Matheussoranco/Jensen-prosthetics/media/renders/mg996r_reference.jpg

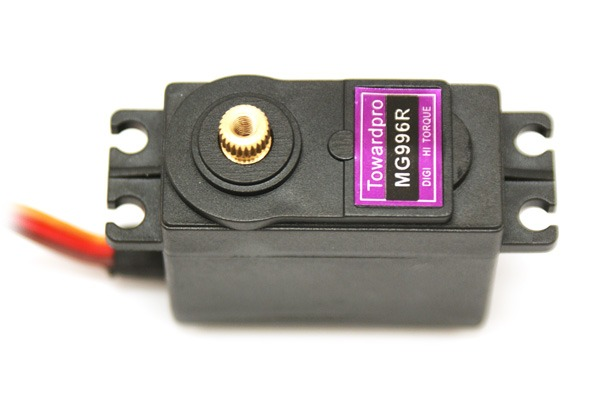
media/renders/mg996r_reference.jpg
