Matheussoranco/Jensen-prosthetics/media/renders/render_02.png

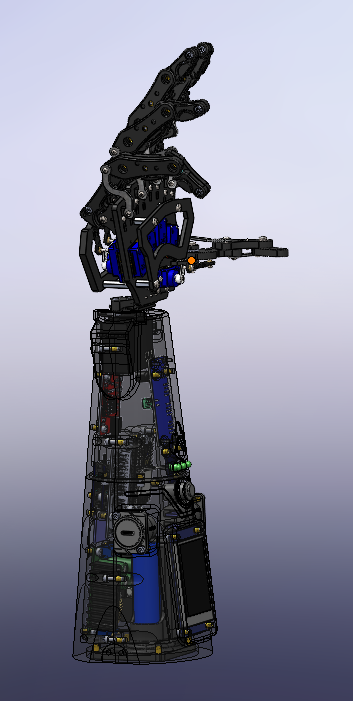
media/renders/render_02.png
