Matheussoranco/Jensen-prosthetics/media/renders/mg996r_reference.png

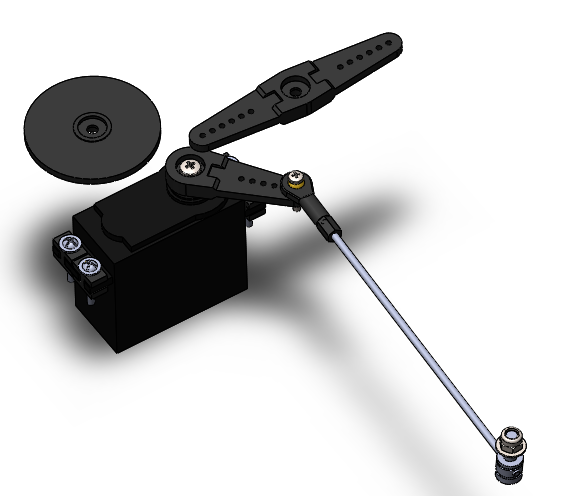
media/renders/mg996r_reference.png
