Matheussoranco/Jensen-prosthetics/media/renders/render_01.png

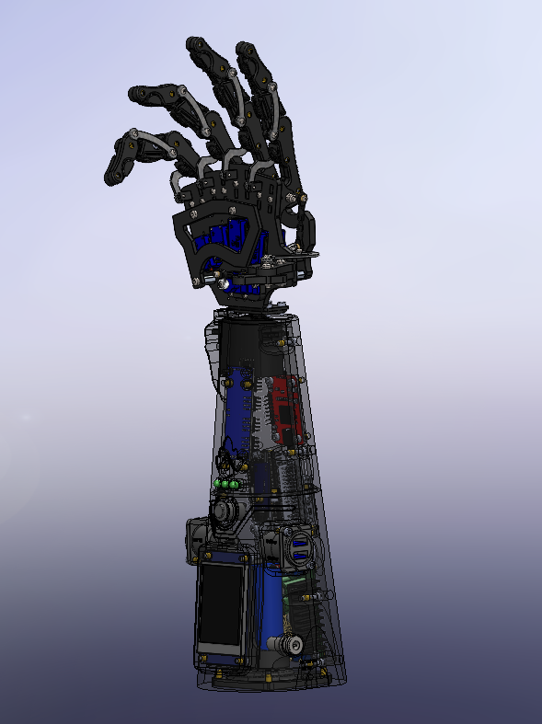
media/renders/render_01.png
