Matheussoranco/Jensen-prosthetics/media/renders/render_03.png

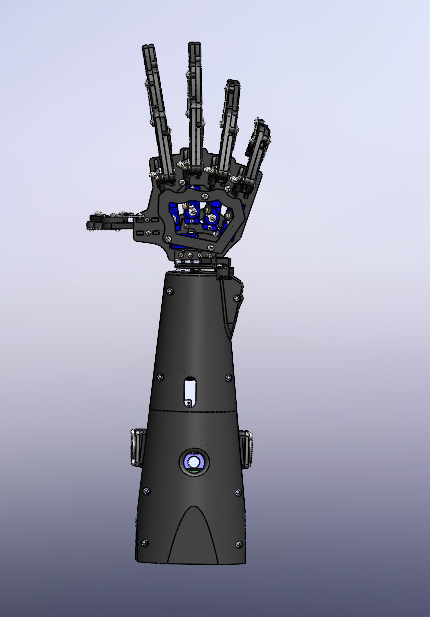
media/renders/render_03.png
