Matheussoranco/Jensen-prosthetics/media/renders/render_04.png

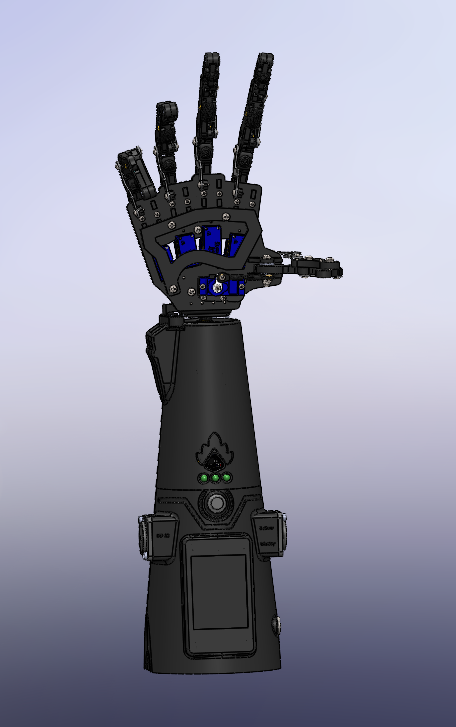
media/renders/render_04.png
