Matheussoranco/Jensen-prosthetics/media/renders/render_05.png

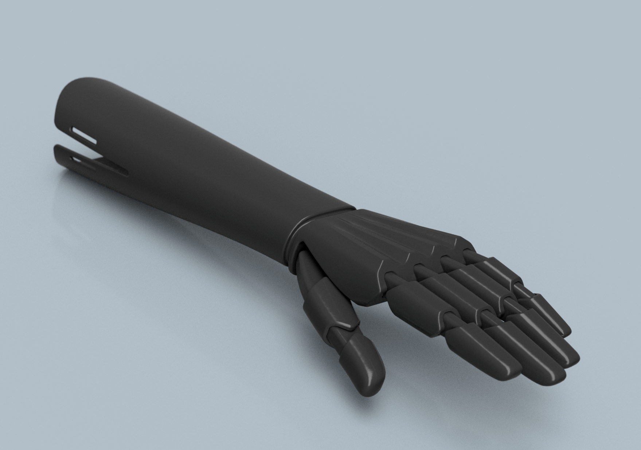
media/renders/render_05.png
