Matheussoranco/Jensen-prosthetics/media/renders/render_06.png

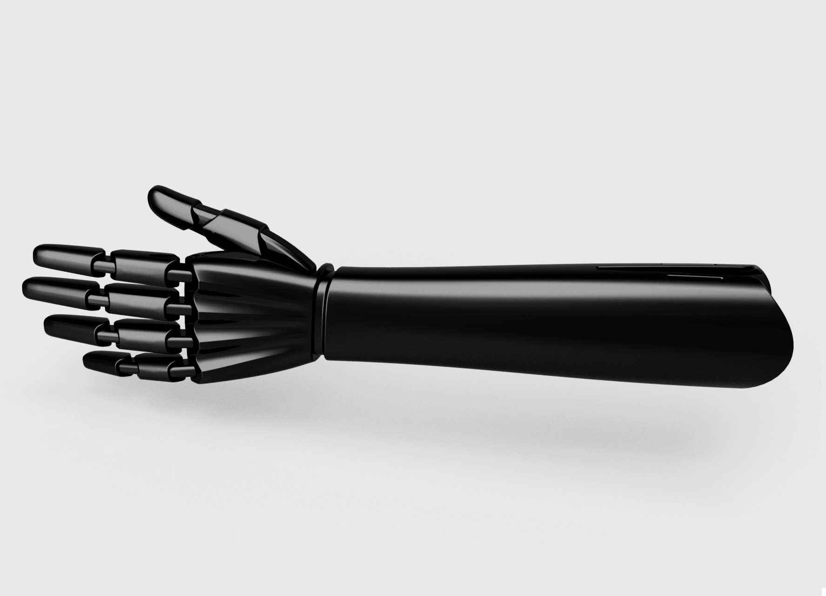
media/renders/render_06.png
