Matheussoranco/Jensen-prosthetics/hardware/components/MG996R_Servo/Att_2_100.STEP

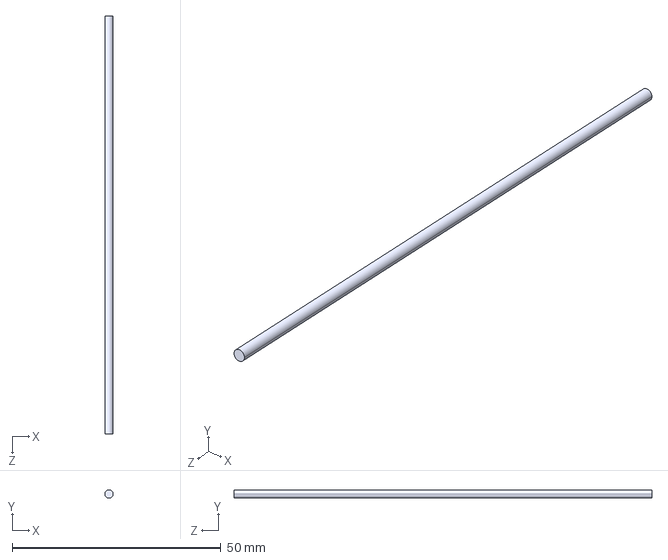
[picture p9: CAD file, 2026-08-06]
hardware/components/MG996R_Servo/Att_2_100.STEP
2.00 x 2.00 x 100.0 mm
