Matheussoranco/Jensen-prosthetics/hardware/components/PCA9685_PWM_Driver.stp

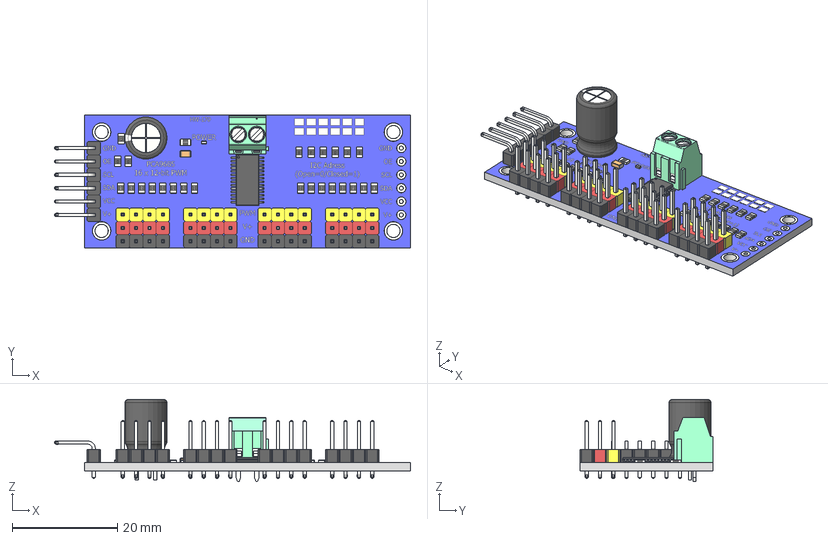
[picture p10: CAD file, 2026-08-06]
hardware/components/PCA9685_PWM_Driver.stp
67.7 x 25.3 x 15.6 mm
