Matheussoranco/Jensen-prosthetics/hardware/stl/Forearm_V1.2-Cut-Revolve1.STL

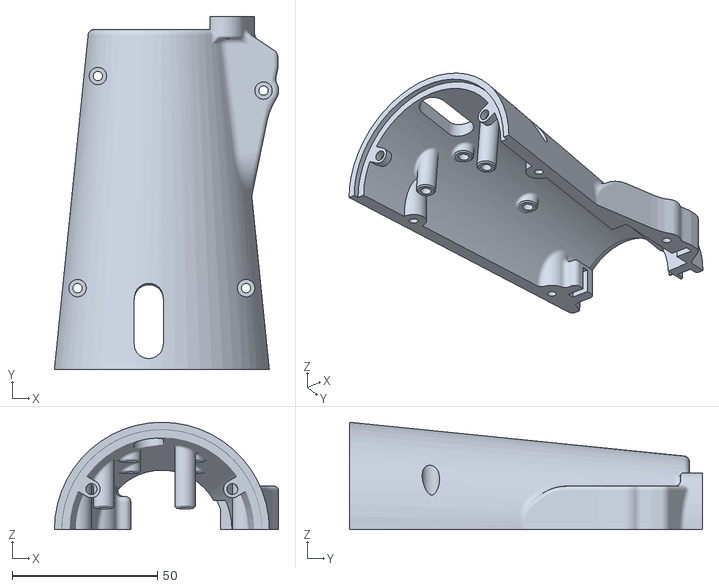
[picture p11: CAD file, 2026-08-06]
hardware/stl/Forearm_V1.2-Cut-Revolve1.STL
77.2 x 121.5 x 37.0
