Matheussoranco/Jensen-prosthetics/hardware/components/MG996R_Servo/Rubber.STEP

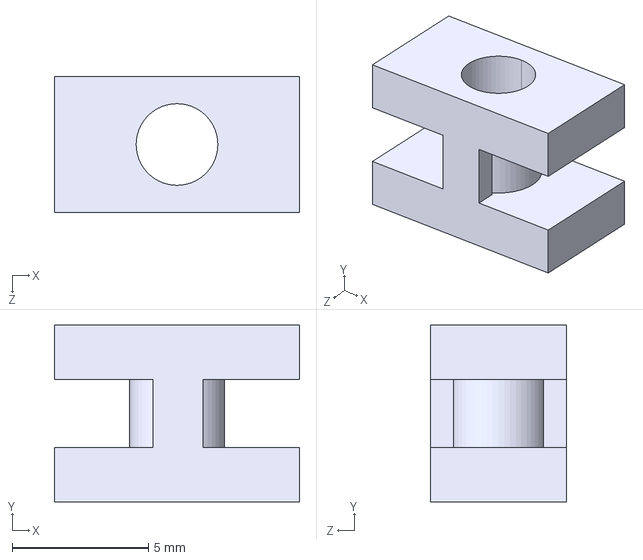
[picture p12: CAD file, 2026-08-06]
hardware/components/MG996R_Servo/Rubber.STEP
9.00 x 6.50 x 5.00 mm
