Matheussoranco/Jensen-prosthetics/hardware/components/Tie_Rod.step

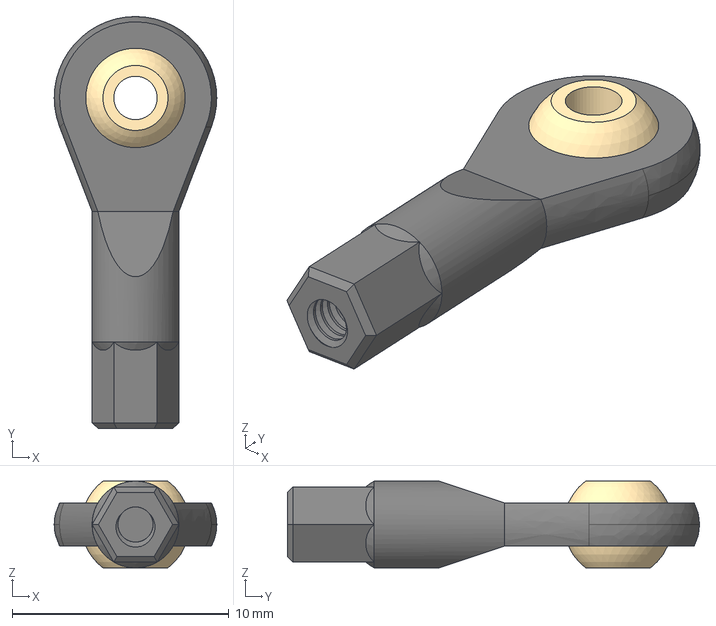
[picture p13: CAD file, 2026-08-06]
hardware/components/Tie_Rod.step
7.50 x 19.0 x 4.00 mm
