Matheussoranco/Jensen-prosthetics/hardware/components/MG996R_Servo/Arm_3.STEP

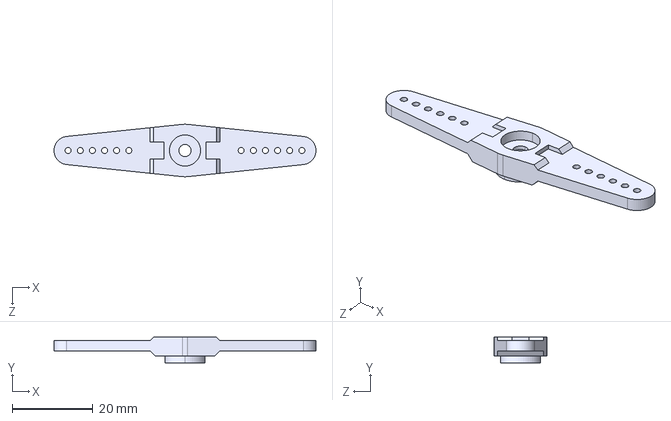
[picture p15: CAD file, 2026-08-06]
hardware/components/MG996R_Servo/Arm_3.STEP
64.8 x 6.40 x 13.0 mm
