Matheussoranco/Jensen-prosthetics/hardware/components/Nextion_2.4in_Display.step

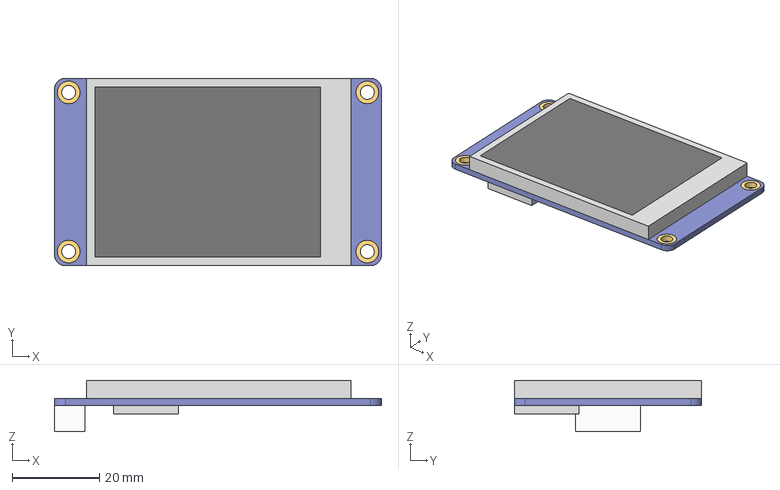
[picture p16: CAD file, 2026-08-06]
hardware/components/Nextion_2.4in_Display.step
75.0 x 43.0 x 11.7 mm
