Matheussoranco/Jensen-prosthetics/hardware/stl/Forearm_V1.2-Cut-Revolve2.STL

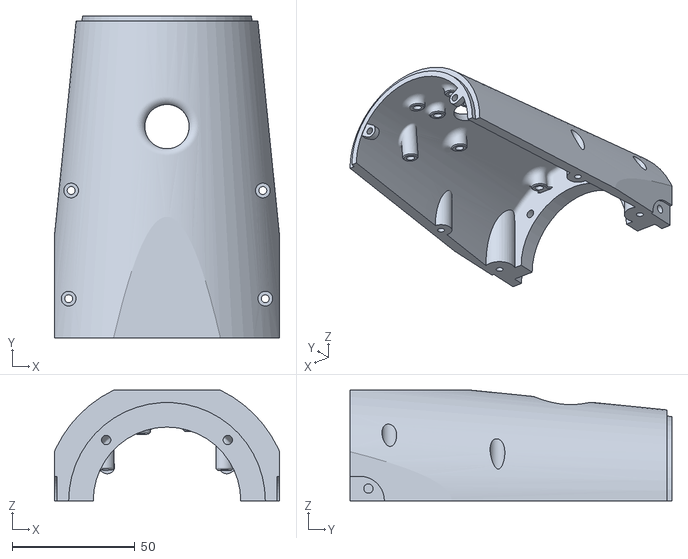
[picture p17: CAD file, 2026-08-06]
hardware/stl/Forearm_V1.2-Cut-Revolve2.STL
91.7 x 131.0 x 45.0
