Matheussoranco/Jensen-prosthetics/hardware/components/ESP32_DevBoard.stp

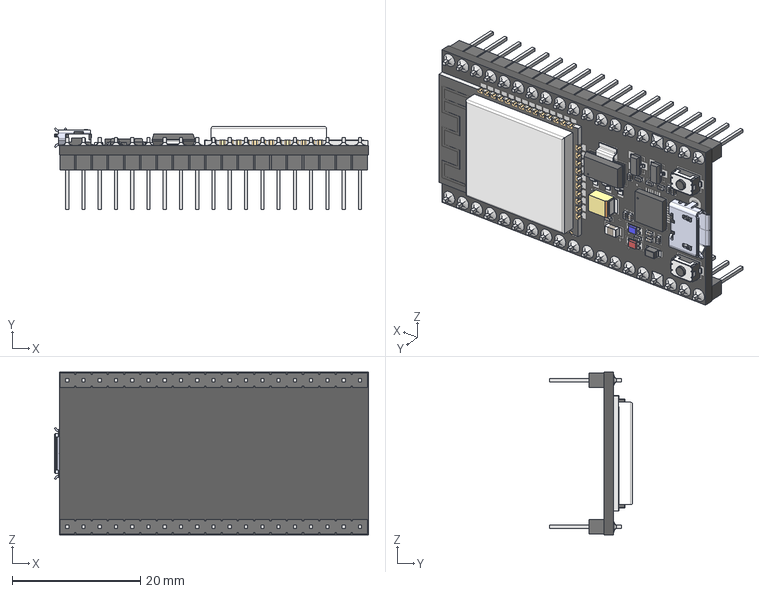
[picture p18: CAD file, 2026-08-06]
hardware/components/ESP32_DevBoard.stp
49.0 x 13.0 x 25.4 mm
