Matheussoranco/Jensen-prosthetics/hardware/components/MG996R_Servo/servo.STEP

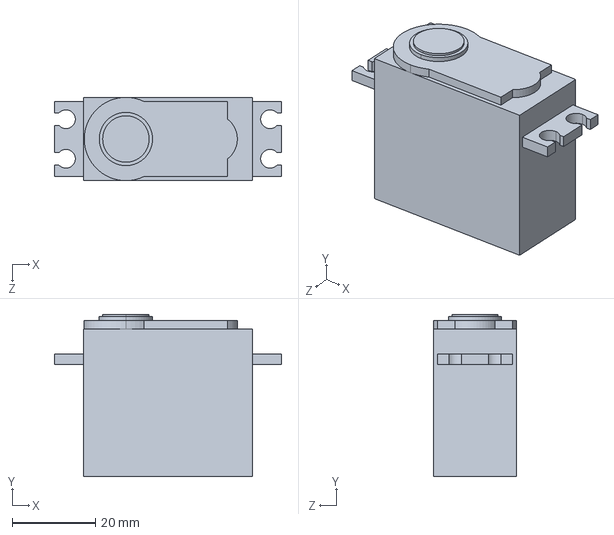
[picture p19: CAD file, 2026-08-06]
hardware/components/MG996R_Servo/servo.STEP
54.5 x 39.0 x 20.0 mm
