Matheussoranco/Jensen-prosthetics/hardware/stl/Base-Palm_Upor_V1.2.STL

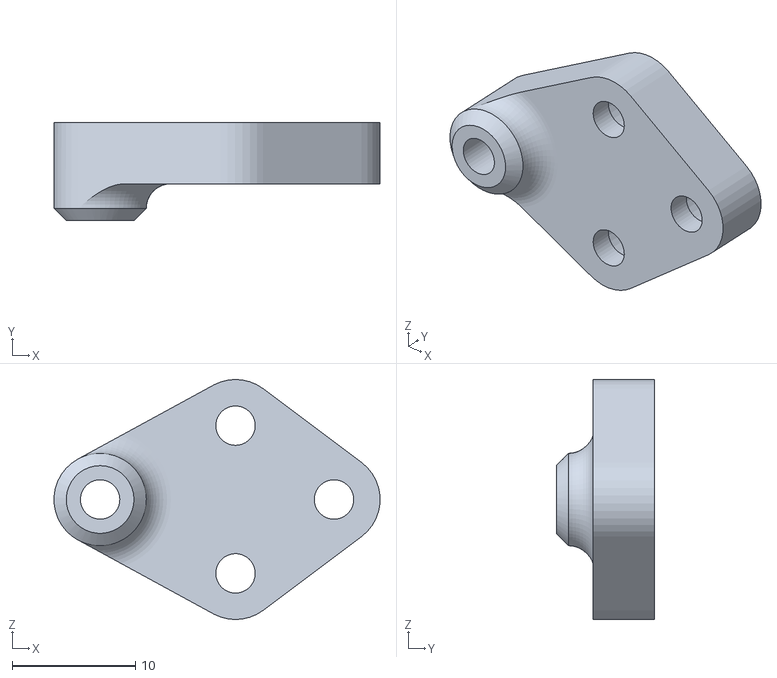
[picture p20: CAD file, 2026-08-06]
hardware/stl/Base-Palm_Upor_V1.2.STL
26.5 x 8.00 x 19.5
