Matheussoranco/Jensen-prosthetics/hardware/components/ESP32_Expansion_Board.step

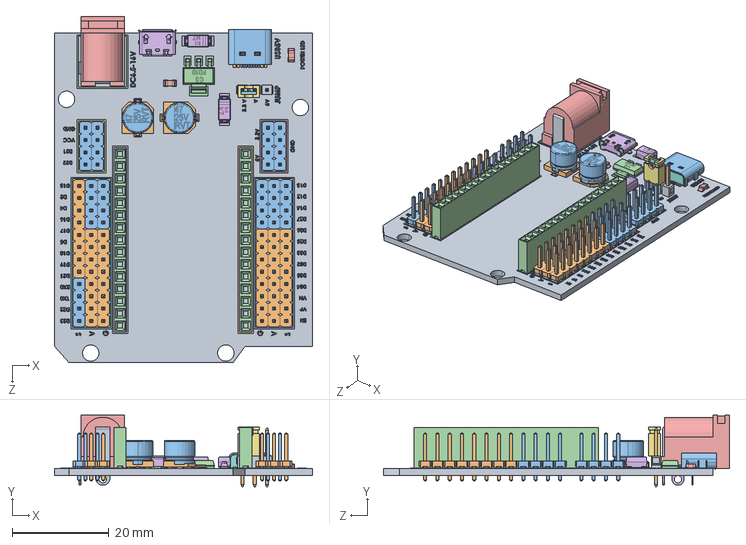
[picture p21: CAD file, 2026-08-06]
hardware/components/ESP32_Expansion_Board.step
53.4 x 14.8 x 71.7 mm
