Matheussoranco/Jensen-prosthetics/hardware/stl/Flanec_2.STL

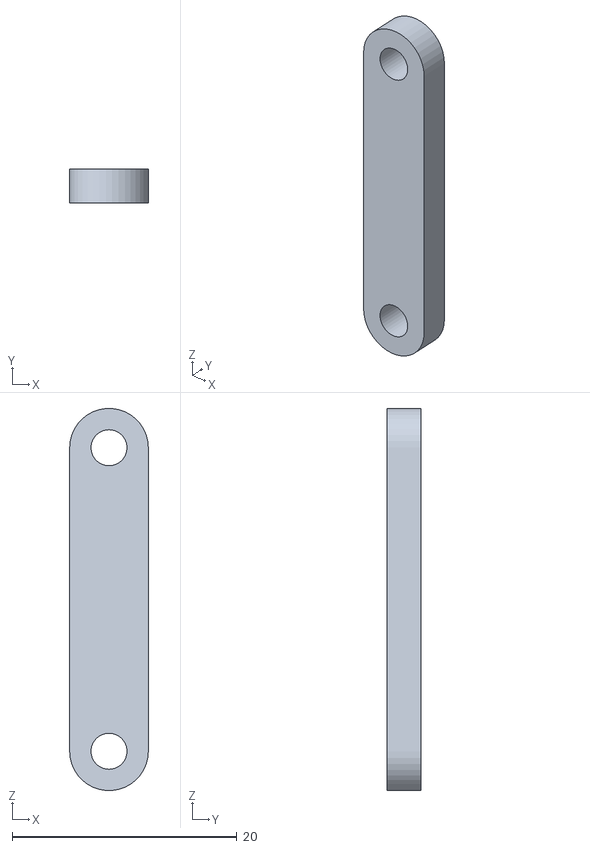
[picture p22: CAD file, 2026-08-06]
hardware/stl/Flanec_2.STL
7.00 x 3.00 x 34.0
