Matheussoranco/Jensen-prosthetics/hardware/components/LED_Green_5mm.stp

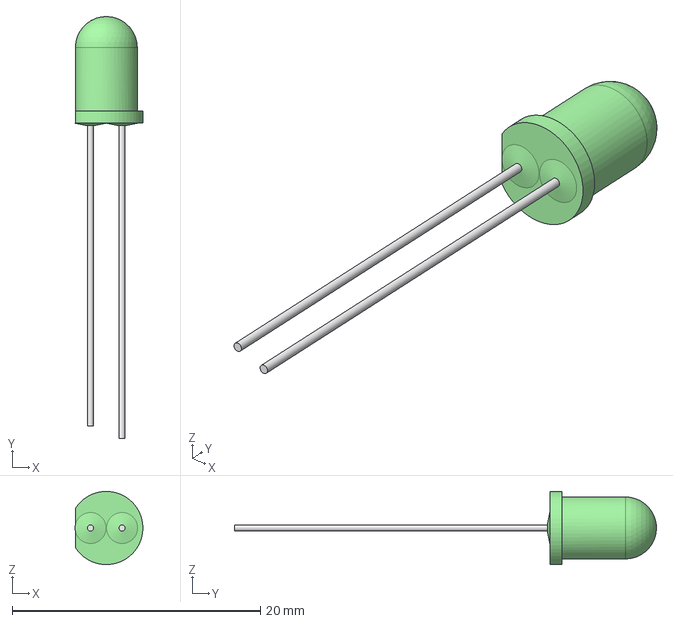
[picture p23: CAD file, 2026-08-06]
hardware/components/LED_Green_5mm.stp
5.47 x 34.0 x 5.90 mm
