Matheussoranco/Jensen-prosthetics/hardware/components/MG996R_Servo/Arm_1.STEP

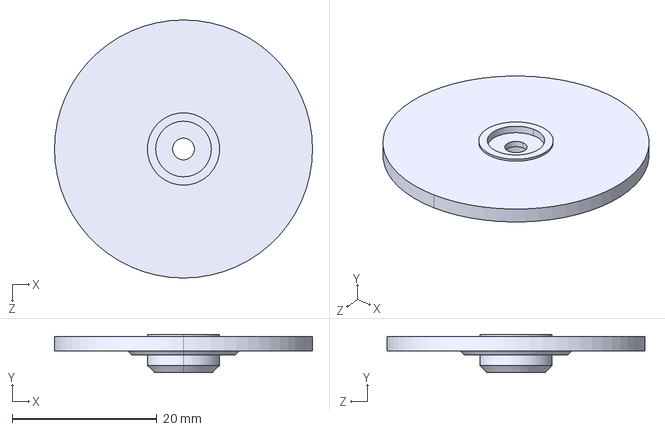
[picture p24: CAD file, 2026-08-06]
hardware/components/MG996R_Servo/Arm_1.STEP
35.7 x 5.30 x 35.7 mm
