Matheussoranco/Jensen-prosthetics/hardware/components/Buck_Converter_5-40V_9A.stp

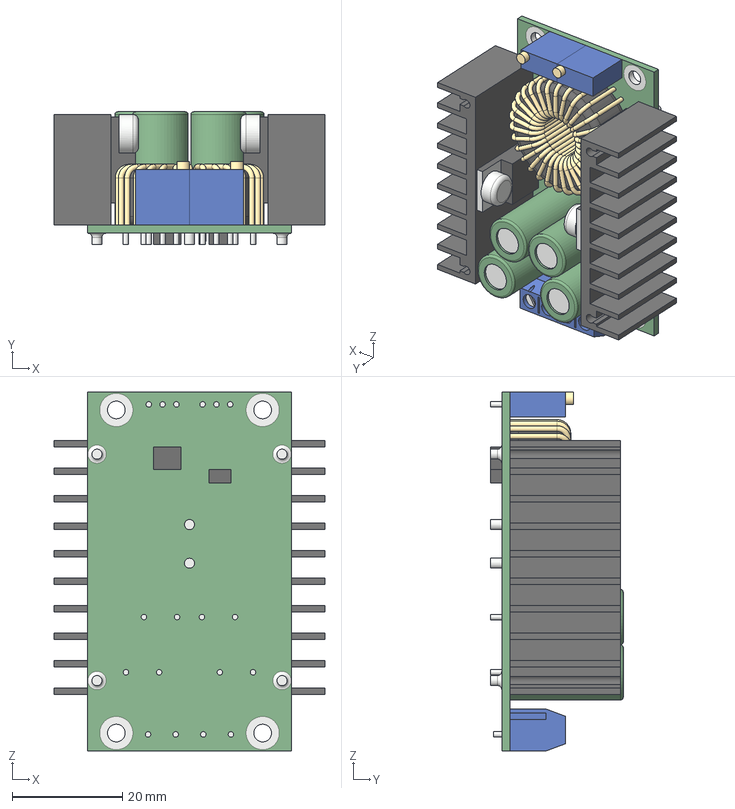
[picture p26: CAD file, 2026-08-06]
hardware/components/Buck_Converter_5-40V_9A.stp
49.0 x 24.0 x 65.0 mm
