Matheussoranco/Jensen-prosthetics/hardware/components/MG996R_Servo/shaft.STEP

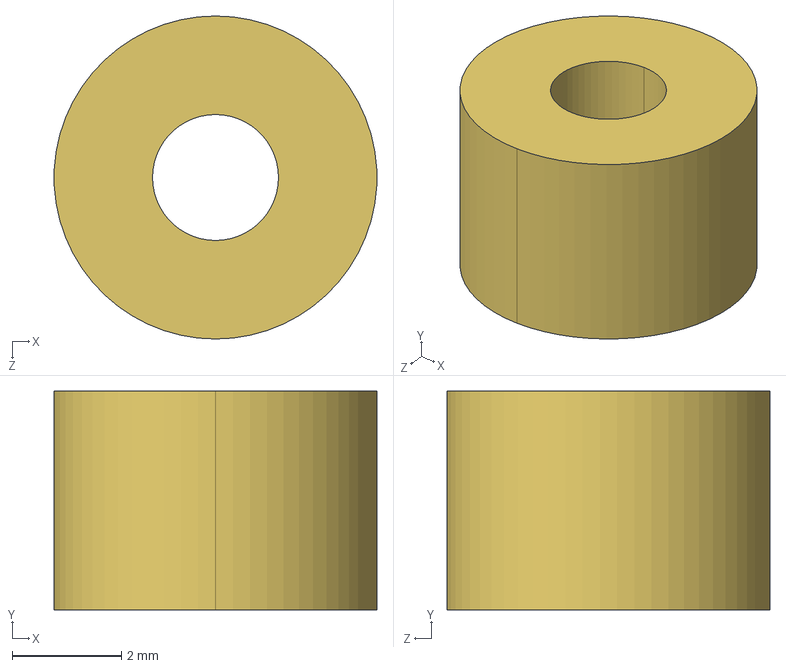
[picture p27: CAD file, 2026-08-06]
hardware/components/MG996R_Servo/shaft.STEP
5.89 x 4.00 x 5.90 mm
