Matheussoranco/Jensen-prosthetics/hardware/stl/Flanec.STL

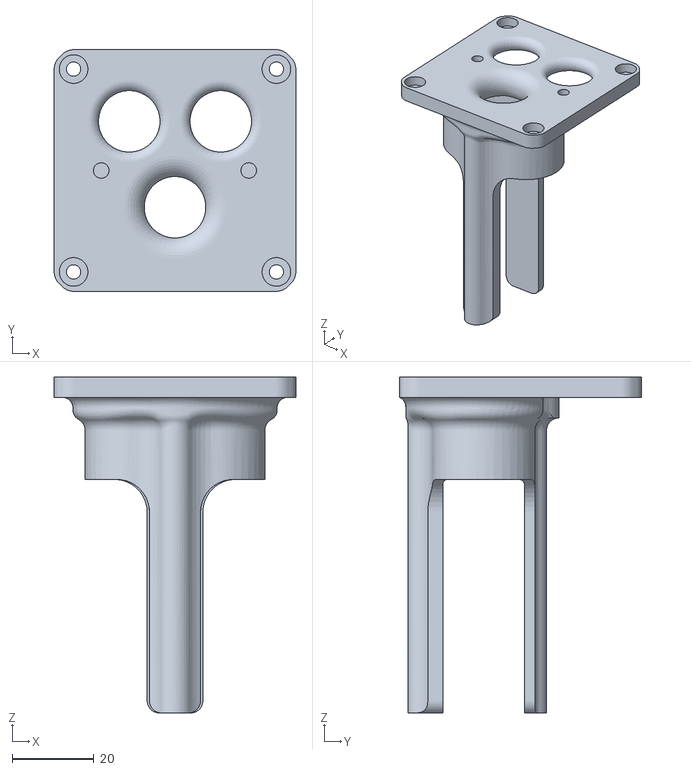
[picture p28: CAD file, 2026-08-06]
hardware/stl/Flanec.STL
59.0 x 59.0 x 82.0
