Matheussoranco/Jensen-prosthetics/hardware/components/MG996R_Servo/Att_3.STEP

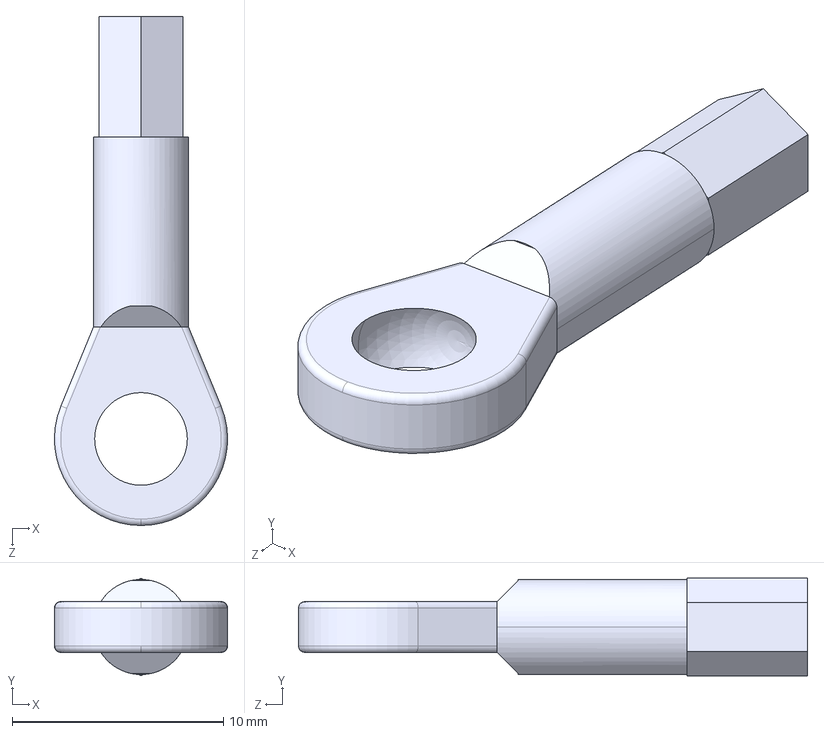
[picture p29: CAD file, 2026-08-06]
hardware/components/MG996R_Servo/Att_3.STEP
8.20 x 4.62 x 24.1 mm
