Matheussoranco/Jensen-prosthetics/hardware/components/MG996R_Servo/Arm_2.STEP

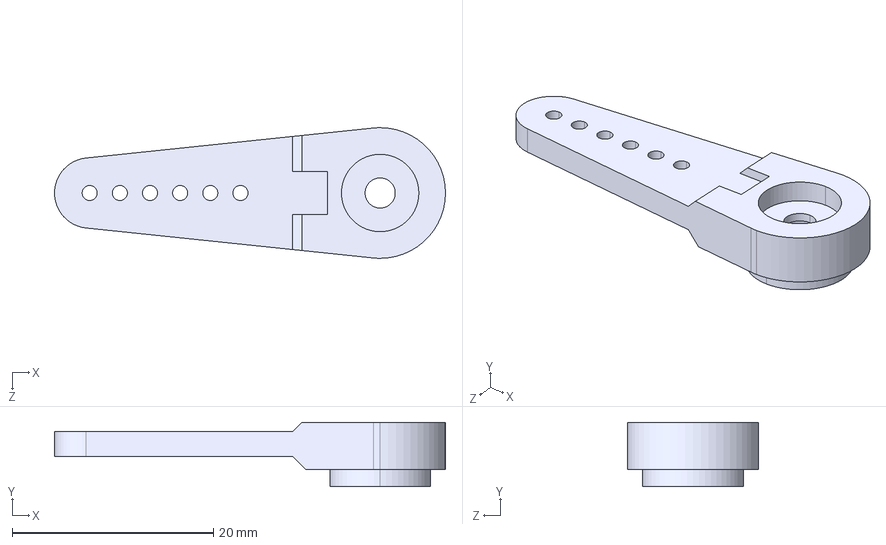
[picture p30: CAD file, 2026-08-06]
hardware/components/MG996R_Servo/Arm_2.STEP
38.9 x 6.40 x 13.0 mm
