Matheussoranco/Jensen-prosthetics/hardware/components/MG996R_Servo/MG996R.STEP

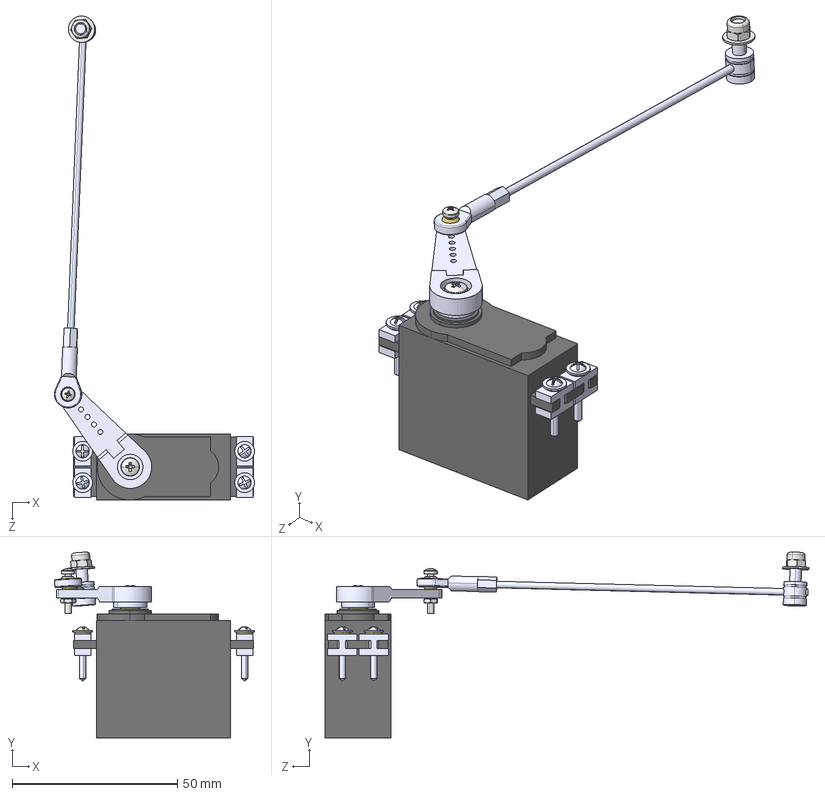
[picture p31: CAD file, 2026-08-06]
hardware/components/MG996R_Servo/MG996R.STEP
60.5 x 56.2 x 146.4 mm
servo
shaft
Rubber x 4
bushing x 4
screw x 4
Arm 2
pan head cross recess screw_din_DIN EN ISO 7045 - M3 x 6 - Z - 6N
Att 1
wave spring lock washer_din_DIN 137-B3-FSt
prevailing torque nut style 1 insert_din_DIN EN ISO 7040 - M3 - N
socket set screw flat point_din_DIN 913 - M4 x 4-N
Att 2 100
Att 3
Att 4
pan head cross recess screw_din_DIN EN ISO 7045 - M2 x 12 - Z - 12N
hex thin nut chamfered gradeab_din_Hexagon Thin Nut ISO 4035 - M2 - N
