Matheussoranco/Jensen-prosthetics/hardware/components/MG996R_Servo/Att_4.STEP

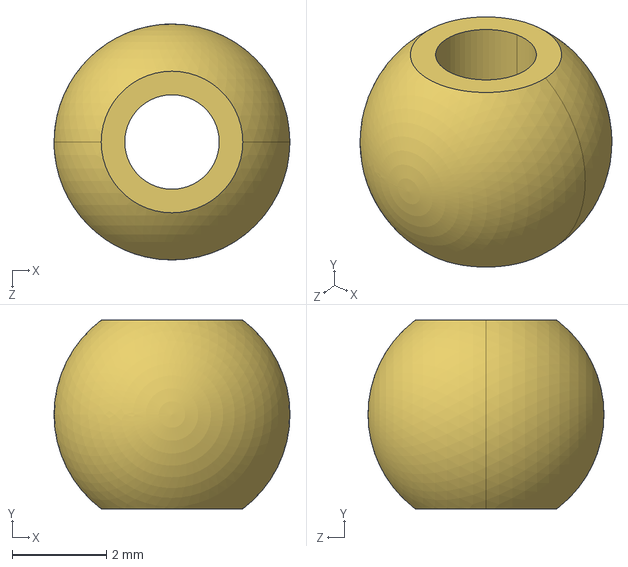
[picture p32: CAD file, 2026-08-06]
hardware/components/MG996R_Servo/Att_4.STEP
5.00 x 4.00 x 5.00 mm
