Matheussoranco/Jensen-prosthetics/hardware/components/MG996R_Servo/bushing.STEP

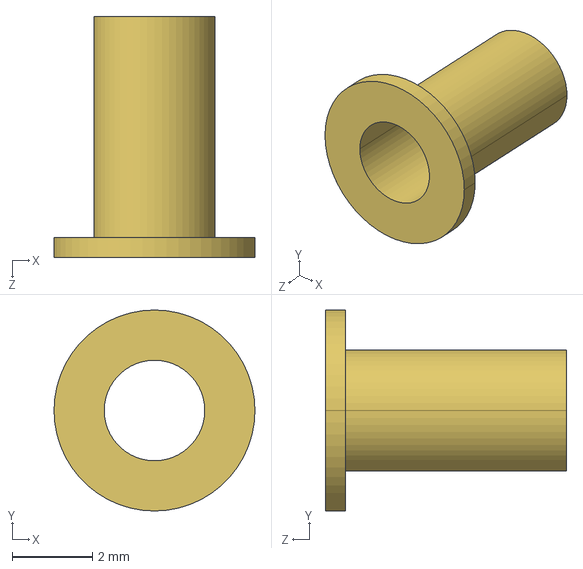
[picture p33: CAD file, 2026-08-06]
hardware/components/MG996R_Servo/bushing.STEP
5.00 x 5.00 x 6.00 mm
