Matheussoranco/Jensen-prosthetics/hardware/components/MG996R_Servo/ATT2.STEP

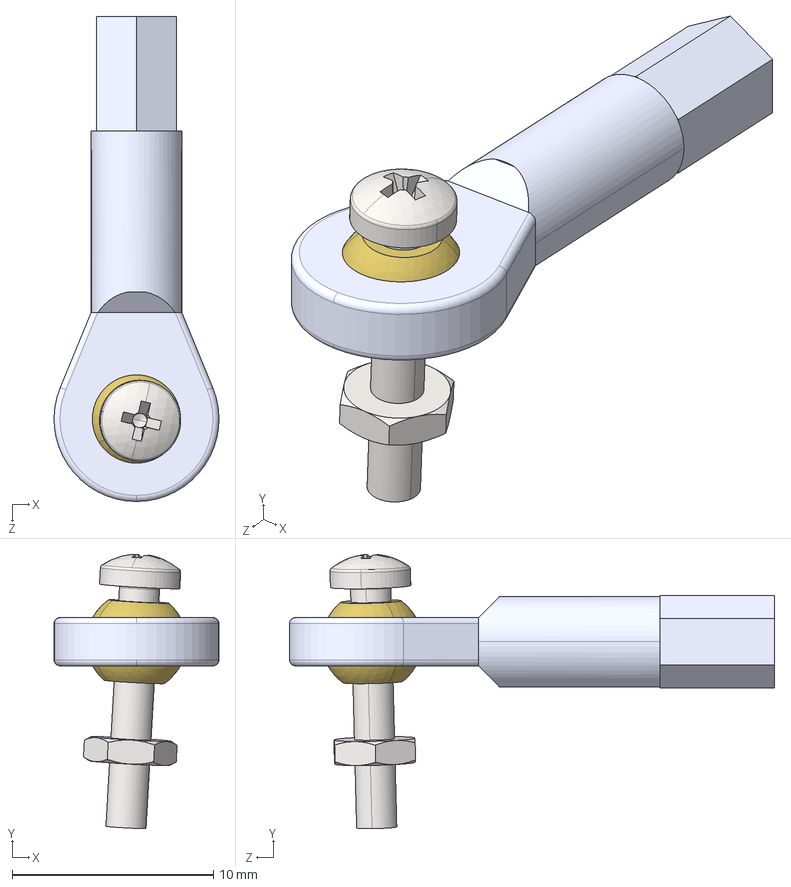
[picture p34: CAD file, 2026-08-06]
hardware/components/MG996R_Servo/ATT2.STEP
8.20 x 13.6 x 24.1 mm
Att 3
Att 4
pan head cross recess screw_din_DIN EN ISO 7045 - M2 x 12 - Z - 12N
hex thin nut chamfered gradeab_din_Hexagon Thin Nut ISO 4035 - M2 - N
