Matheussoranco/Jensen-prosthetics/hardware/components/MG996R_Servo/ATT1.STEP

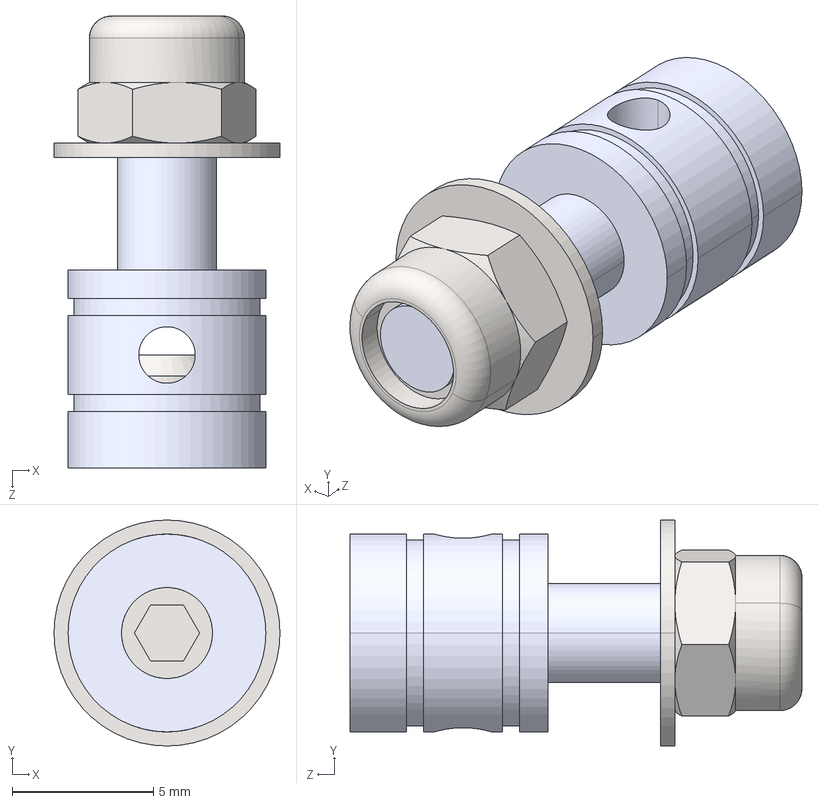
[picture p35: CAD file, 2026-08-06]
hardware/components/MG996R_Servo/ATT1.STEP
8.00 x 8.00 x 16.0 mm
Att 1
wave spring lock washer_din_DIN 137-B3-FSt
prevailing torque nut style 1 insert_din_DIN EN ISO 7040 - M3 - N
socket set screw flat point_din_DIN 913 - M4 x 4-N
