Matheussoranco/Jensen-prosthetics/(list of files, cad)

Other CAD files:
hardware/assembly/Jensen_Hand_Assembly.step
hardware/components/MG996R_Servo/Att_1.STEP
hardware/components/MG996R_Servo/screw.STEP
