Matheussoranco/Jensen-prosthetics/(commit log)

2026-08-06 Open-source release: cleaned CAD (STEP/STL), technical README, CC BY-NC-SA 4.0 license, third-party attribution
    - Publish full hand+forearm assembly and component reference geometry in
    open STEP/STL formats under hardware/
    - Strip personal authoring metadata (author, timestamps, local file paths)
    from all published STEP files and re-encode renders to drop any
    embedded metadata
    - Exclude native SolidWorks (.SLDPRT/.SLDASM) source: files use a
    compressed container that can't be reliably verified/scrubbed with
    available tooling
    - Credit Ivo Maric's passive hand cover design (MyMiniFactory,
    Credit-Remix-Noncommercial) in third_party/ and NOTICE.md
    - Add CC BY-NC-SA 4.0 LICENSE (proje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
    [ATT1.STEP, ATT2.STEP, Arm_1.STEP, Arm_2.STEP, Arm_3.STEP, Att_1.STEP, Att_2_100.STEP, Att_3.STEP]
2026-08-07 ESP32 control firmware: myoelectric proportional control, grasp library, closed-loop grip force
    Adds the firmware the README previously listed as future work.
    Architecture
    ------------
    The control policy lives in firmware/lib/jensen_core/ and contains no Arduino
    code, so the entire behaviour of the hand runs on a host against synthetic
    inputs. firmware/src/ only samples ADCs and writes servo pulses.
    Control
    -------
    - Two-electrode proportional control: flexor closes, extensor opens, activation
    integrated into a single aperture command. Single-electrode mode available.
    - Seven grasp patterns (power, pinch, tripod, key, point, hook, rest), selected
    by button or by co-contraction, with bl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
2026-08-13 Add new firmware components and documentation
    Jensen Hand firmware v1.0 with safety system, pattern recognition and
    verification framework
2026-09-19 Refactor `clamp` function for NaN safety and add error handling to `SerialCli::update`
    [serial_cli.cpp, serial_cli.h]
2026-10-16 Add CI workflow and exclude motor stall from STO
    Add a GitHub Actions CI workflow to run core tests and syntax checks,
    and remove `kFaultMotorStall` from the severe faults that trigger Safe
    Torque Off, allowing unaffected digits to continue holding objects.
    [test_core.cpp]
2026-10-23 Update documentation and license to CC BY-NC-SA 4.0
    Update the project license to require ShareAlike, add disclaimers
    clarifying that the hand is currently unbuilt and in the design stage,
    and document discrepancies between the CAD assembly and the firmware.
